sanPns/KOBE_FOC/HardWare/BOM_KOBE_FOC.xlsx

No. | Quantity | Comment | Designator | Footprint | Value | Manufacturer Part | Manufacturer | Supplier Part | Supplier
1 | 6 | 1uF | C1,C7,C8,C9,C13,C22 | C0603 | 1uF
2 | 19 | 100nF | C2,C3,C4,C5,C6,C12,C29,C31,C32,C33,C34,C35,C36,C37,C38,C39,C52,C53,C54 | C0603 | 100nF
3 | 3 | 2.2uF | C10,C11,C51 | C0603 | 2.2uF
4 | 2 | 12pF | C14,C15 | C0603 | 12pF
5 | 2 | 22pF | C16,C17 | C0603 | 22pF
6 | 1 | 100uF | C27 | CAP-SMD_BD6.3-L6.6-W6.6-LS7.2-FD | 100uF | RVT100UF16V67RV0016 | KNSCHA(科尼盛) | C2887276 | LCSC
7 | 1 | 10uF | C28 | CAP-SMD_BD4.0-L4.3-W4.3-LS5.0-FD | 10uF | VT10UF16V167RV0128 | KNSCHA(科尼盛) | C5246581 | LCSC
8 | 1 | 4.7uF | C30 | C0603 | 4.7uF
9 | 1 | 1uF | C48 | C0603 | 1uF | 0603B103K500NT | FH(风华) |  | LCSC
10 | 1 | 47pF | C49 | C0603 | 47pF | CL10C470JB8NNNC | SAMSUNG(三星) | C1671 | LCSC
11 | 1 | 22uF | C50 | C0603 | 22uF | CL10A226MQ8NRNC | SAMSUNG(三星) | C59461 | LCSC
12 | 3 | WAFER-SH1.0-4PWB | CN2,CN3,CN4 | CONN-SMD_4P-P1.00_WAFER-SH1.0-4PWB |  | WAFER-SH1.0-4PWB | XUNPU(讯普) | C3029343 | LCSC
13 | 1 | SMFJ3.3CA | D1 | SOD-123_L2.7-W1.6-LS3.7-BI |  | SMFJ3.3CA | BORN(伯恩半导体) | C511919 | LCSC
14 | 6 | 1N4148W | D2,D3,D4,D5,D6,D7 | SOD-123_L2.8-W1.8-LS3.7-RD |  | 1N4148W | CJ(江苏长电/长晶) | C2099 | LCSC
15 | 3 | FR107 | D8,D9,D10 | SOD-123_L2.8-W1.8-LS3.7-RD |  | FR107 | BORN(伯恩半导体) | C511885 | LCSC
16 | 1 | 1N5819W | D11 | SOD-123_L2.7-W1.6-LS3.7-RD-1 |  | 1N5819W | TECH PUBLIC(台舟) | C2905650 | LCSC
17 | 1 | PZ254V-11-04P | H9 | HDR-TH_4P-P2.54-V-M |  | PZ254V-11-04P | XFCN(兴飞) | C2691448 | LCSC
18 | 1 | 2.54-2*3P针 | J1 | HDR-TH_6P-P2.54-V-M-R2-C3-S2.54-1 |  | 2.54-2*3P针 | BOOMELE(博穆精密) | C65114 | LCSC
19 | 1 | 6.8uH | L2 | IND-SMD_L4.4-W4.2 | 6.8uH | FXL0420-6R8-M | cjiang(长江微电) | C177241 | LCSC
20 | 1 | ME6211C33M5G-N | LDO1 | SOT-23-5_L3.0-W1.7-P0.95-LS2.8-BL |  | ME6211C33M5G-N | MICRONE(南京微盟) | C82942 | LCSC
21 | 2 | LED_0603-R | LED1,LED2 | LED_0603
22 | 1 | N096-2864KSWEG01-H30 | OLED1 | OLED_0.96-30P-P0.70-12864 |  | N096-2864KSWEG01-H30 | Newvision(新智景) | C2890596 | LCSC
23 | 6 | IRFH7440TRPBF | Q1,Q2,Q3,Q4,Q5,Q6 | DFN-8_L5.8-W4.9-P1.27-LS6.0-BL-1 |  | IRFH7440TRPBF | Infineon(英飞凌) | C67862 | LCSC
24 | 2 | 1K | R1,R11 | R0603 | 1K
25 | 1 | 0Ω | R2 | R0603 | 0Ω
26 | 2 | 5K1 | R3,R4 | R0603 | 5K1
27 | 15 | 10K | R5,R6,R9,R10,R12,R13,R14,R15,R16,R17,R18,R23,R24,R42,R43 | R0603 | 10K
28 | 1 | 910K | R7 | R0603 | 910K
29 | 2 | 120R | R8,R36 | R0603 | 120R
30 | 3 | 采样电阻 | R22,R25,R26 | R1206 | 采样电阻
31 | 6 | 20R | R27,R28,R29,R30,R31,R32 | R0603 | 20R
32 | 3 | 100R | R33,R34,R35 | R0603 | 100R
33 | 1 | 5.1kΩ | R39 | R0603 | 5.1kΩ | RS-03K5101FT | FH(风华) | C156350 | LCSC
34 | 1 | 1kΩ | R40 | R0603 | 1kΩ | 0603WAF1001T5E | UNI-ROYAL(厚声) | C21190 | LCSC
35 | 1 | 1MΩ | R41 | R0603 | 1MΩ | 0603WAF1004T5E | UNI-ROYAL(厚声) | C22935 | LCSC
36 | 5 | TS-1088R-02026 | SW1,SW2,SW3,SW4,SW5 | SW-SMD_L3.9-W3.0-P4.45 |  | TS-1088R-02026 | XUNPU(讯普) | C455280 | LCSC
37 | 1 | KH-SS12D01-G3-5.0 | SW6 | SW-TH_KH-SS12D01-G3-5.0 |  | KH-SS12D01-G3-5.0 | kinghelm(金航标) | C5274456 | LCSC
38 | 4 | M2螺丝 | TP1,TP2,TP3,TP4 | M2螺丝
39 | 1 | EG2133 | U1 | TSSOP-20_L6.5-W4.4-P0.65-LS6.4-BL |  | EG2133 | EG(屹晶微) | C190343 | LCSC
40 | 1 | BL3085(I47) | U2 | SOP-8_L4.9-W3.9-P1.27-LS6.0-BL |  | BL3085(I47) | BL(上海贝岭) | C2960453 | LCSC
41 | 1 | WAFER-SH1.0-5PWB | U4 | CONN-SMD_5P-P1.00_XUNPU_WAFER-SH1.0-5PWB |  | WAFER-SH1.0-5PWB | XUNPU(讯普) | C3029344 | LCSC
42 | 1 | REF3033AIDBZR | U6 | SOT-23-3_L3.0-W1.7-P0.95-LS2.9-BR |  | REF3033AIDBZR | TI(德州仪器) | C36658 | LCSC
43 | 1 | CH340N | U7 | SOP-8_L4.9-W3.9-P1.27-LS6.0-BL |  | CH340N | WCH(南京沁恒) | C2977777 | LCSC
44 | 3 | INA199A1DCKR | U11,U12,U13 | SC-70-6_L2.2-W1.3-P0.65-LS2.1-BR |  | INA199A1DCKR | TI(德州仪器) | C59135 | LCSC
45 | 1 | TJA1050T/CM,118 | U14 | SOIC-8_L5.0-W4.0-P1.27-LS6.0-BL |  | TJA1050T/CM,118 | NXP(恩智浦) | C6952 | LCSC
46 | 1 | MR30-M | U15 | CONN-TH_MR30-M |  | MR30-M | AMASS(艾迈斯) | C99873 | LCSC
47 | 1 | ME3116AM6G | U16 | SOT-23-6_L2.9-W1.6-P0.95-LS2.8-BL |  | ME3116AM6G | MICRONE(南京微盟) | C97643 | LCSC
48 | 1 | STM32G431CBU6 | U17 | UFQFPN-48_L7.0-W7.0-P0.50-BL-EP |  | STM32G431CBU6 | ST(意法半导体) | C529356 | LCSC
49 | 1 | LM321MFX | U18 | SOT-23-5_L2.9-W1.6-P0.95-LS2.8-BL |  | LM321MFX | TECH PUBLIC(台舟) | C3011196 | LCSC
50 | 1 | TYPE-C 16PIN 2MD(073) | USB1 | USB-C-SMD_TYPE-C-6PIN-2MD-073 |  | TYPE-C 16PIN 2MD(073) | SHOU HAN(首韩) | C2765186 | LCSC
51 | 1 | 8MHz | X1 | OSC-SMD_4P-L3.2-W2.5-BL | 8MHz | X32258MOB4SI | YXC(扬兴晶振) | C2682775 | LCSC
52 | 1 | 32.768kHz | X2 | OSC-SMD_L3.2-W1.5 | 32.768kHz | X321532768KGD2SI | YXC(扬兴晶振) | C620155 | LCSC
