sanPns/KOBE_FOC/(list of files, drawings)

Other design files:
HardWare/KOBE_FOC.epro
KOBE_FOC.epro
