sanPns/KOBE_FOC/SoftWare/focu/Core/Src/main.c

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
/* Includes ------------------------------------------------------------------*/
#include "main.h"
#include "adc.h"
#include "dma.h"
#include "fdcan.h"
#include "i2c.h"
#include "spi.h"
#include "tim.h"
#include "usart.h"
#include "gpio.h"

/* USER CODE BEGIN Includes */
#include <stdio.h>
#include "OLED_Drv.h"
#include "Encoder.h"
#include "Driver.h"
#include "CmdOrder.h"

/* USER CODE END Includes */


/* USER CODE BEGIN PV */
uint16_t Adcx[2] = {0};

/* USER CODE END PV */

void SystemClock_Config(void);
/* USER CODE BEGIN 0 */

void HAL_ADC_ConvCpltCallback(ADC_HandleTypeDef *hadc)
{
	float fil = 0.5f;
	// Ŵ    Ŵ 50            Ϊ0.005       Ե      V/0.005/50    V*4
	float t0 = (((float)Adcx[0]) / 4096.0f * 3.3f - 1.65f) * 4;
	float t1 = (((float)Adcx[1]) / 4096.0f * 3.3f - 1.65f) * 4;

	//             ʹ   ˵ ͨ ˲   ʵ    Ч       ã  ˲       񶯵      ݴ   һ   ͺ   
	Cur_val[0] = t0 * (1.0f - fil) + Cur_val[0] * fil;
	Cur_val[1] = t1 * (1.0f - fil) + Cur_val[1] * fil;
	Cur_val[2] = -Cur_val[1] - Cur_val[0];
	// printf("%.2f,%.2f,%.2f\n",Cur_val[0],Cur_val[1],Cur_val[2]);
}

void HAL_TIM_PeriodElapsedCallback(TIM_HandleTypeDef *htim)
{
	if (htim == &htim2)
	{
	}
	if (htim == &htim3)
	{
		FOC_Cycle();
	}
}

void HAL_GPIO_EXTI_Callback(uint16_t GPIO_Pin)
{
	if (GPIO_Pin == KEY1_Pin)
	{
	}
	if (GPIO_Pin == KEY2_Pin)
	{
	}
	if (GPIO_Pin == KEY3_Pin)
	{
	}
	if (GPIO_Pin == KEY4_Pin)
	{
	}
}
/* USER CODE END 0 */

/**
 * @brief  The application entry point.
 * @retval int
 */
int main(void)
{

	/* MCU Configuration--------------------------------------------------------*/

	/* Reset of all peripherals, Initializes the Flash interface and the Systick. */
	HAL_Init();

	/* Configure the system clock */
	SystemClock_Config();

	/* Initialize all configured peripherals */
	MX_GPIO_Init();
	MX_DMA_Init();
	MX_ADC1_Init();
	MX_FDCAN1_Init();
	MX_I2C1_Init();
	MX_TIM1_Init();
	MX_USART2_UART_Init();
	MX_USART3_UART_Init();
	MX_UART4_Init();
	MX_SPI1_Init();
	MX_TIM2_Init();
	MX_TIM3_Init();
	MX_SPI2_Init();
	/* USER CODE BEGIN 2 */

	AngInit();
	//   ʼ    Ƕ 
	CmdOrder_Init(&huart3);
	//   ʼ  ָ     
	HAL_TIM_Base_Start_IT(&htim2);
	//      ʱ  ԭ      ˢ  oled  Ļ      Ϊ    дUI     Բ û  ʹ    
	HAL_TIM_Base_Start_IT(&htim3);
	//    FOC  ʱ  
	HAL_GPIO_WritePin(GPIOB, GPIO_PIN_5, GPIO_PIN_RESET);
	// ʹ  485ͨ  
	HAL_ADCEx_Calibration_Start(&hadc1, ADC_SINGLE_ENDED);
	// У׼ADC    

	// u8g2_t u8g2;
	// OLED_Init(&hspi1, &u8g2);
	//   ʼ  u8g2ͼ ο⣬    ͼ ο      ֲ

	/* USER CODE END 2 */

	/* Infinite loop */
	/* USER CODE BEGIN WHILE */
	while (1)
	{
		/* USER CODE END WHILE */

		/* USER CODE BEGIN 3 */
	}
	/* USER CODE END 3 */
}

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
