sanPns/KOBE_FOC/SoftWare/focu/focu.ioc

Mcu.UserName=STM32G431CBUx
PA0.Signal=ADC1_IN1
PA1.Signal=ADC1_IN2
PA10.Signal=S_TIM1_CH3
PA11.Signal=FDCAN1_RX
PA12.Signal=FDCAN1_TX
PA13.Signal=SYS_JTMS-SWDIO
PA14.Signal=SYS_JTCK-SWCLK
PA15.Signal=I2C1_SCL
PA2.Signal=ADC1_IN3
PA4.GPIO_Label=OLED_DC
PA4.Signal=GPIO_Output
PA5.Signal=SPI1_SCK
PA6.GPIO_Label=OLED_RES
PA6.Signal=GPIO_Output
PA7.Signal=SPI1_MOSI
PA8.Signal=S_TIM1_CH1
PA9.Signal=S_TIM1_CH2
PB0.GPIO_Label=KEY3
PB0.Signal=GPXTI0
PB1.GPIO_Label=KEY2
PB1.Signal=GPXTI1
PB10.Signal=USART3_TX
PB11.Signal=USART3_RX
PB13.Signal=SPI2_SCK
PB14.Signal=GPIO_Output
PB15.Signal=SPI2_MOSI
PB2.GPIO_Label=KEY1
PB2.Signal=GPXTI2
PB3.Signal=USART2_TX
PB4.Signal=USART2_RX
PB5.Signal=GPIO_Output
PB7.Signal=I2C1_SDA
PB9.Signal=GPIO_Output
PC10.Signal=UART4_TX
PC11.Signal=UART4_RX
PC13.Signal=GPIO_Output
PC14-OSC32_IN.Signal=RCC_OSC32_IN
PC15-OSC32_OUT.Signal=RCC_OSC32_OUT
PC4.GPIO_Label=KEY4
PC4.Signal=GPXTI4
PF0-OSC_IN.Signal=RCC_OSC_IN
PF1-OSC_OUT.Signal=RCC_OSC_OUT
