sanPns/KOBE_FOC/SoftWare/focu/Core/Inc/main.h

#define HIGH GPIO_PIN_SET
#define LOW GPIO_PIN_RESET
#define PI 3.1415926f
#define sqrt3 1.7320508f
#define OLED_DC_Pin GPIO_PIN_4
#define OLED_DC_GPIO_Port GPIOA
#define OLED_RES_Pin GPIO_PIN_6
#define OLED_RES_GPIO_Port GPIOA
#define KEY4_Pin GPIO_PIN_4
#define KEY4_GPIO_Port GPIOC
#define KEY4_EXTI_IRQn EXTI4_IRQn
#define KEY3_Pin GPIO_PIN_0
#define KEY3_GPIO_Port GPIOB
#define KEY3_EXTI_IRQn EXTI0_IRQn
#define KEY2_Pin GPIO_PIN_1
#define KEY2_GPIO_Port GPIOB
#define KEY2_EXTI_IRQn EXTI1_IRQn
#define KEY1_Pin GPIO_PIN_2
#define KEY1_GPIO_Port GPIOB
#define KEY1_EXTI_IRQn EXTI2_IRQn
