sanPns/KOBE_FOC/(commit log)

2024-12-18 上传了软件部分
    [BOM_KOBE_FOC.xlsx, KOBE_FOC.epro]
2024-12-20 优化了代码结构，增加必要注释
2024-12-20 添加图片
